kmetz/coro2sens/(threads)

Thread 1 (2020-09-05):

Warning levels too high

RainerWinkler, 2020-09-05:
Hi Mr Metz,
Thanks for building and sharing:-)
The recommended level for the red light during the COVID-19 pandemic I am aware of is 1000 ppm. You may check this.
See also my blog where I collected the understanding I have currently on this https://medium.com/@rainer.winkler.poaceae/recommendations-for-use-of-co2-sensors-to-control-room-air-quality-during-the-covid-19-pandemic-c04cac6644d0
Best regards,
Rainer

kmetz, 2020-09-05:
Hi Rainer, thank you for reporting this! I will read the documents an will propably adjust the levels (and make them configurable more easily). Your medium article seems to be a great reference, thanks for that.

kmetz, 2020-09-05:
I made thresholds configurable in code and changed defaults to 800/1000 ppm for yellow/red. The old 1000/2000 values are still mentioned in code.

RainerWinkler, 2020-09-05:
Hi Kaspar,
thanks!
Best regards and success with you project!
Rainer

Closed 2020-09-05.

Thread 2 (2020-09-23):

Captive Portal: DHCP not working on Android, Windows

kmetz, 2020-09-23:
A user reported he got no IP address when connecting in captive portal mode, both on Android and on Windows 10. It worked with a manual IP.

ESP32.

Thread 3 (2020-11-11):

BME280 | bme280 stops after the first reading

floriandusch, 2020-11-11:
Hi @kmetz,
thanks a lot for the great instructions. Everything works beautifully over here.
The only small issue i have is, that `bme280isConnected` changes to false after the first reading of the BME280 sensor.
I can't seem to solve it... any pointers?

Thanks much in advance!

kmetz, 2020-11-12:
Thanks! I will lok into this ASAP.

kmetz, 2020-11-16:
Ok, with the much appreciated help and feedback of @htor-j I was able to fix this, BME280 has to run in `MODE_NORMAL` instead of `MODE_FORCED`, the latter requires to re-set forced mode before each reading (it goes into sleep mode afterwards). Normal mode will update readings internally periodically and is also recommended when using filters (see datasheet).

kmetz, 2020-11-16:
Please use 71cc1216 / v1.2.2 +.

floriandusch, 2020-11-16:
It's working now. Thanks for the fix, @kmetz!

Closed 2020-11-16.

Thread 4 (2022-03-25):

Compiling error (solved)

M4rt1n12, 2022-03-25:
Hi,

I just finished your instructions. I have an ESP8266 board, a Seeed SCD30 and a 3V piezo speaker. I had to download and integrate almost all of the libraries as zips because they were not found in the board manager.

I do not need the LED function and the BME280. When I wanted to compile the script, I got the following error message:

Arduino: 1.8.20 Hourly Build 2021/12/20 07:34 (Mac OS X), Board: "Arduino Uno"

```
In file included from /Users/privat/Downloads/coro2sens/coro2sens/coro2sens/coro2sens.ino:99:0:
/Users/privat/Documents/Arduino/libraries/ESPAsyncWebServer-master/src/ESPAsyncWebServer.h:26:10: fatal error: functional: No such file or directory
 #include <functional>
          ^~~~~~~~~~~~
compilation terminated.
exit status 1
Error compiling for Arduino Uno board.

This report would be more detailed if the option
"Verbose output during compilation"
in File -> Preferences would be activated.
```

Do the errors occur because the components are missing?

M4rt1n12, 2022-03-25:
I compiled it with VSCode, there it works. Is it possible to access the data with command line? Because I have no WLAN chip yet.

kmetz, 2022-03-26:
Thanks for reporting issues with using the Arduino IDE.

I assume you used PlatformIO with VSCode? It would then have downloaded all dependencies.

Data is printed out on the serial port, so you can just monitor it with the ESP connected via USB. When using PlatformIO you can simply open a serial monitor with `pio device monitor` on the command line (in the project directory).

kmetz, 2022-03-26:
Following up on issues with the Arduino IDE: Have you also looked in the library manager? It's separate from the board manager.

M4rt1n12, 2022-03-26:
>

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

unfortunaly the command pio doesn't work in my VSCode

M4rt1n12, 2022-03-26:
> @M4rt1n12 Following up on issues with the Arduino IDE: Have you also looked in the library manager? It's separate from the board manager.

OH there it is! But the board itself I had to add with a link I added in the preferences.

kmetz, 2022-03-30:
So you had success?

Regarding `pio`: maybe try `platformio` instead of `pio` (which is a short version which might not be available depending on the installation). I must admit I'm unfamiliar with PlatformIO under windows.

The error you posted before refers to a hardware debugger device which is not found (and also not needed):
```
Error: unable to open ftdi device with vid 0403, pid 6010, description '*', serial '*' at bus location '*'
```

This seems related to the build mode being misconfigured somehow in VSCode.

M4rt1n12, 2022-03-31:
Hallo Kaspar,
the board was recently recognized less and less, neither on the active nor on the passive usb hub connected to my macbook pro. I have already set the baud rate to 115200, but it no longer works. After some google I found some hints [here](https://forum.arduino.cc/t/esp-8266-timed-out-waiting-for-packet-header/597634/17) Maybe a firmware downgrade or reset board in flash mode helps

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

`platformio` is also not recognized:

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

M4rt1n12, 2022-04-18:
Hi Kaspar,
I just bought the ESP32 and it works! But the SCD30 is quite inaccurate (I definitly don't have 26.5° C temperature, more 20-21°, anyway the CO2 sensor seems to work fine). I've got the BME280, did I get it right that I need some kind of Y-Link so that VCC of SCD and BME get the same PIN on the board?

Closed 2022-04-18.
