kmetz/coro2sens/(commit log)

2020-08-31 bugfix: reverse switch levels
2020-09-02 log all sensor values
2020-09-05 make flashing easier for Arduino IDE users
2020-09-10 fix beeps on ESP32
    [coro2sens.ino]
2020-09-16 fix ESP32 WiFi trouble: avoid ADC2 pins, change to FastLED, remove switch
    [coro2sens.ino]
2020-09-16 add optional activity LED
2020-09-23 fix LOG_MINUTES setting (one hour)
    [coro2sens.ino]
2020-09-23 remove esp32_exception_decoder for esp12e
